dai-hongtao/InkTime/esp32/pcb/pcb.jpeg

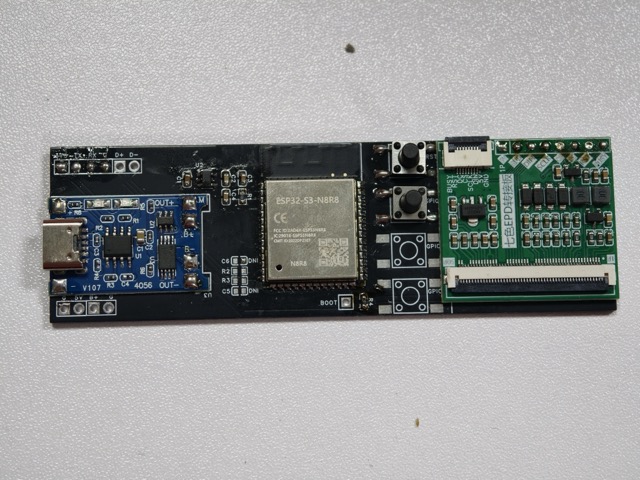
esp32/pcb/pcb.jpeg
