dai-hongtao/InkTime/esp32/pcb/Schematic.pdf

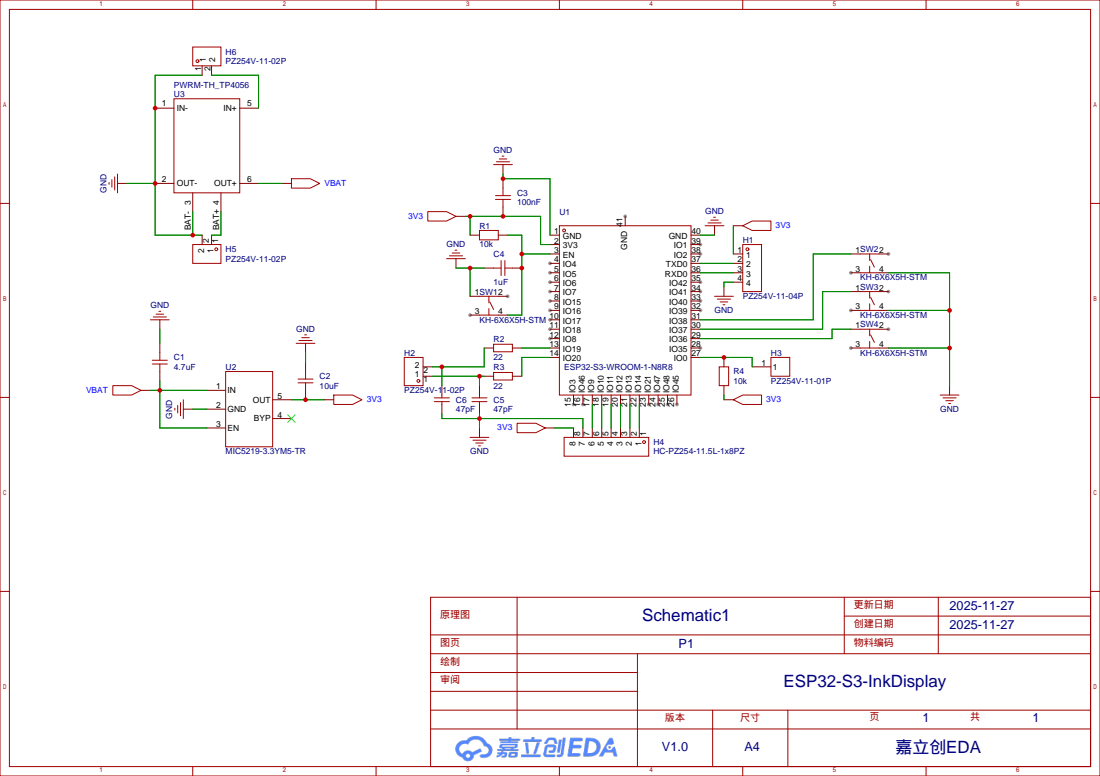
[picture p3: page 1]
